7enderhead/kbdwtchdg/doc/changelog.rst

*********
Changelog
*********

    * 11.08.2017:
         Initial commit

    * 16.08.2017:
		 re-organizing folder structure
		 
		 adapting GPL

    * 17.08.2017:
		 added pictures and diagrams
		 
		 added documentation

    * 21.08.2017:
		 Added antiweb how-to

    * 23.08.2017:
		 Added WTCHDG mode

    * 28.08.2017:
		 Added state indicator
		 
		 new state diagrams
		 
		 reworked main() with switch statement

    * 30.08.2017:
		 Added inter-key-delay
		 
		 Added documentation for settig the fuses
