7enderhead/kbdwtchdg/(commit log)

2017-08-17 added soldering layout, removed docs
2017-08-18 Adjusted code to actual board
2017-08-21 added board photo
2017-08-21 resized board photo
2017-08-28 Updated state diagram, adjusted switch statement
2017-08-30 Added documentation for setting the fuses
2017-08-30 Fixes for latest commit
    [main.c]
2017-08-30 replaced tabs with whitespaces to unify the code. Changelog update
    [main.c]
